diyan07-ctrl/esp32-gesture-controlled-drone/hardware/schematics/README.md

# Electrical drawing status

The provisional net drawings are [drone wiring](../../diagrams/drone-wiring.mmd), [glove wiring](../../diagrams/glove-wiring.mmd) and [power](../../diagrams/power-distribution.mmd). These are functional wiring diagrams, not a verified PCB schematic or manufacturing netlist. Actual ESC connector order, breakout supply circuit, buck model and ADC protection remain unresolved. Do not order a PCB or assemble guessed connector pinouts. Final CAD capture and ERC are blocked until exact parts are identified.
