diyan07-ctrl/esp32-gesture-controlled-drone/simulation/reports/reference/dashboard.png

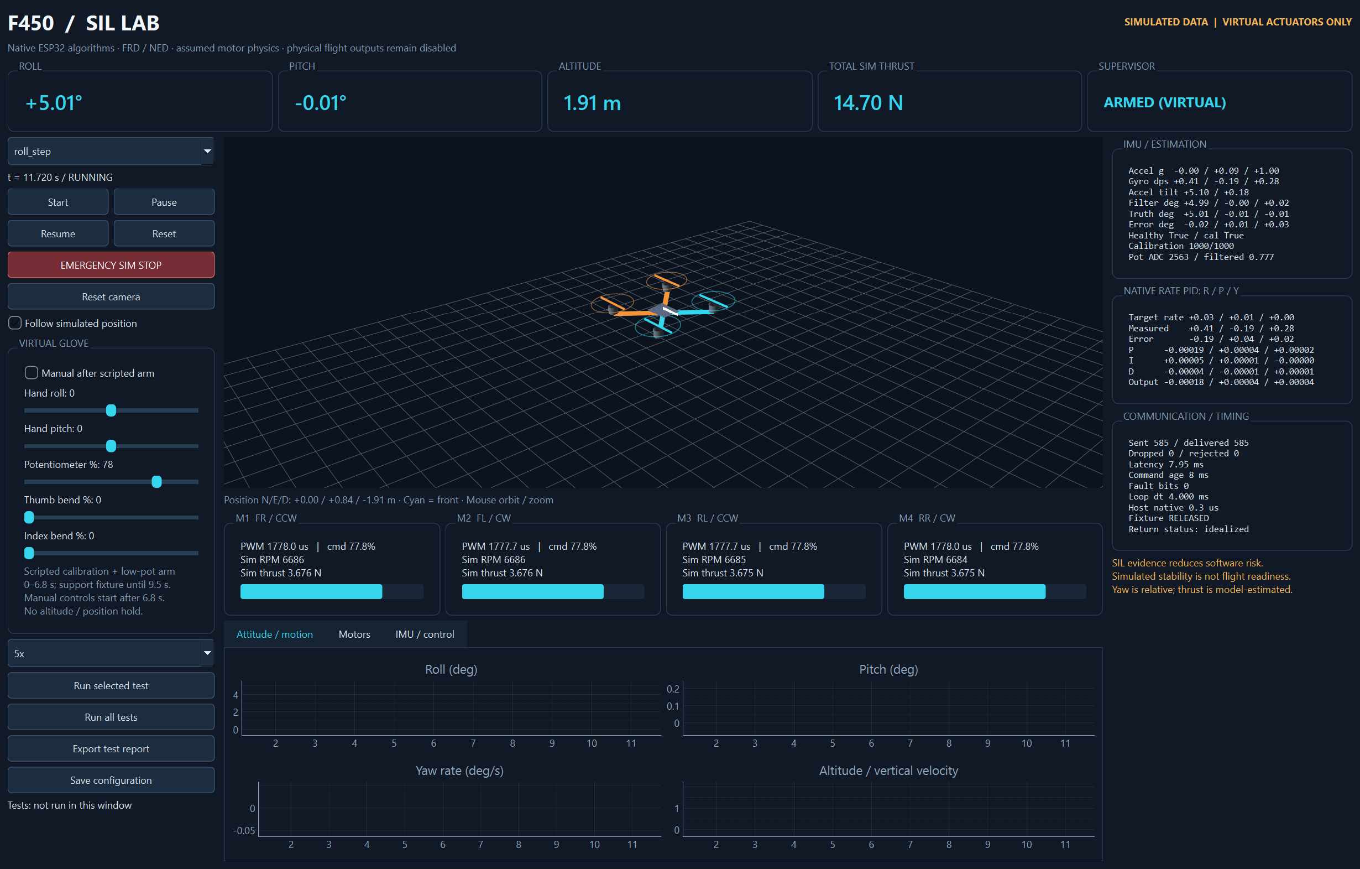
simulation/reports/reference/dashboard.png
