diyan07-ctrl/esp32-gesture-controlled-drone/simulation/reports/reference/fault-dashboard-3d.png

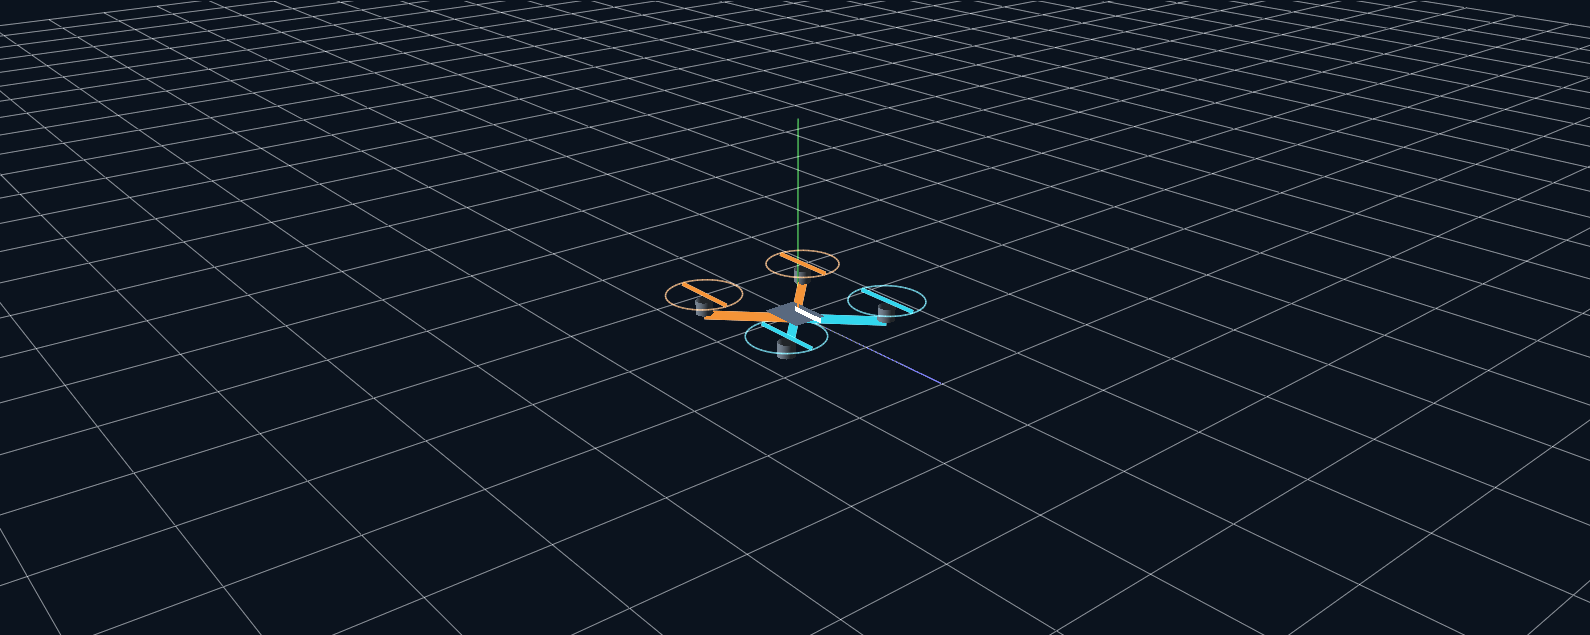
simulation/reports/reference/fault-dashboard-3d.png
