diyan07-ctrl/esp32-gesture-controlled-drone/simulation/reports/reference/plots/filter_gradual.png

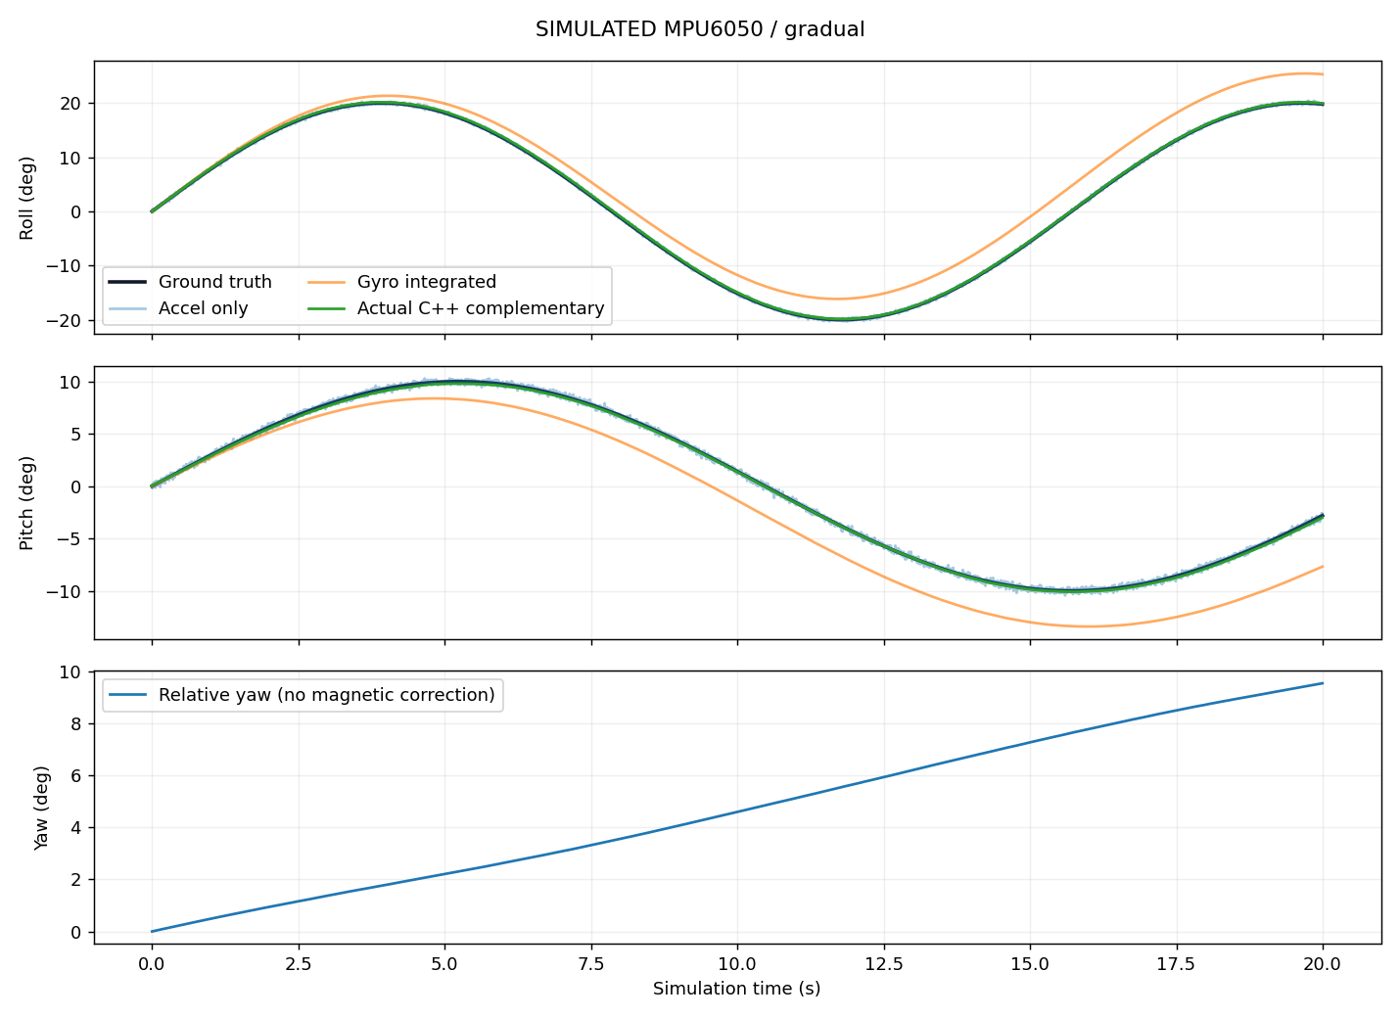
simulation/reports/reference/plots/filter_gradual.png
