diyan07-ctrl/esp32-gesture-controlled-drone/simulation/reports/reference/plots/filter_sudden.png

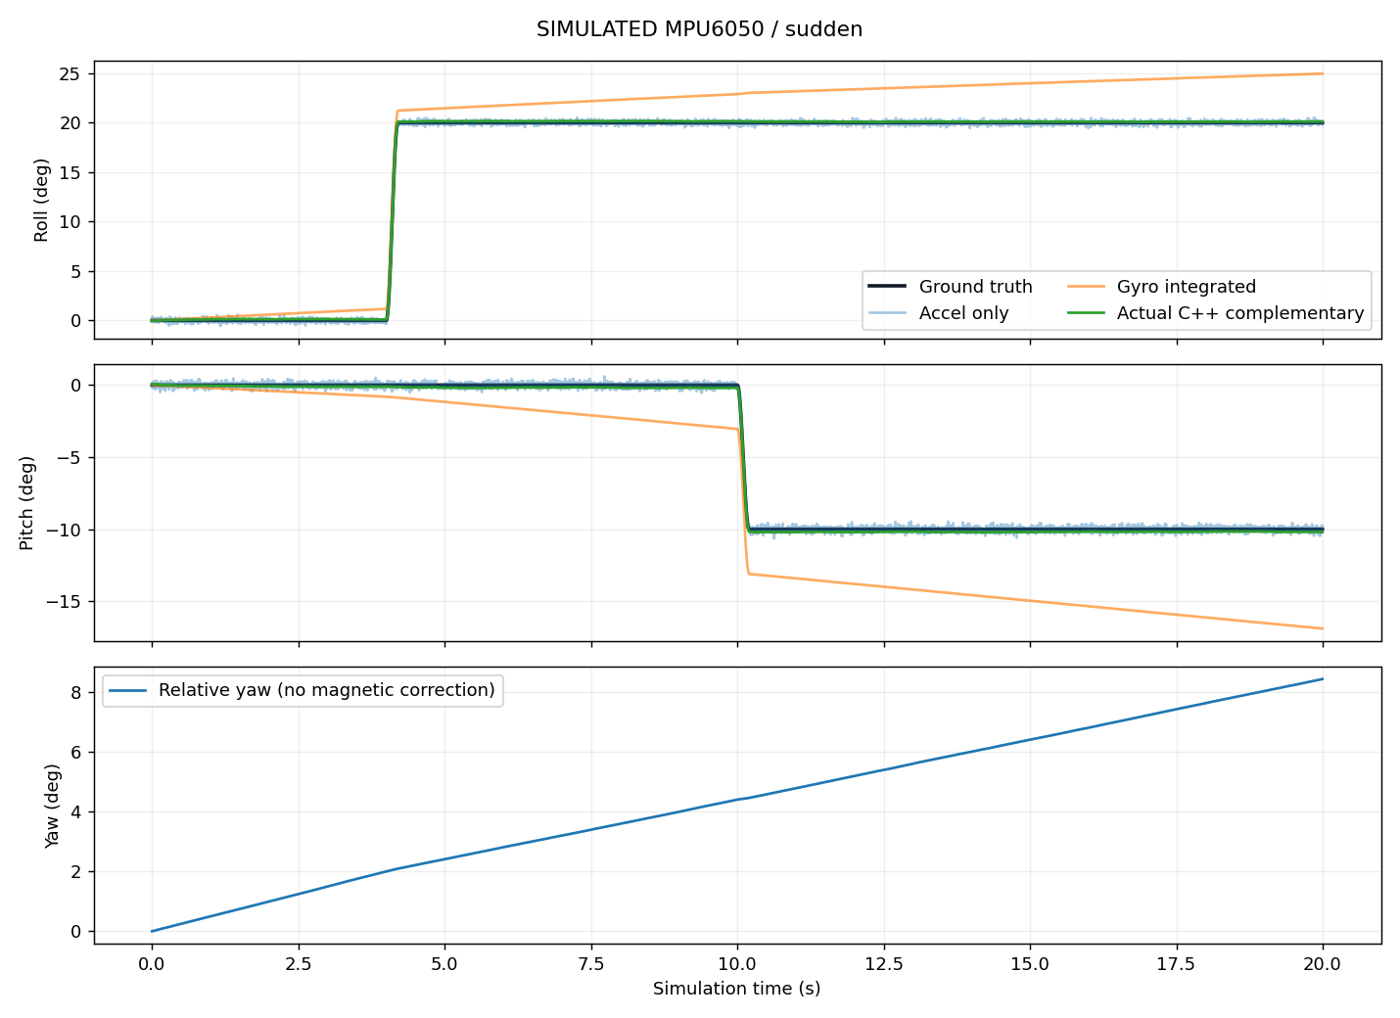
simulation/reports/reference/plots/filter_sudden.png
