diyan07-ctrl/esp32-gesture-controlled-drone/simulation/reports/reference/plots/scenario_arming.png

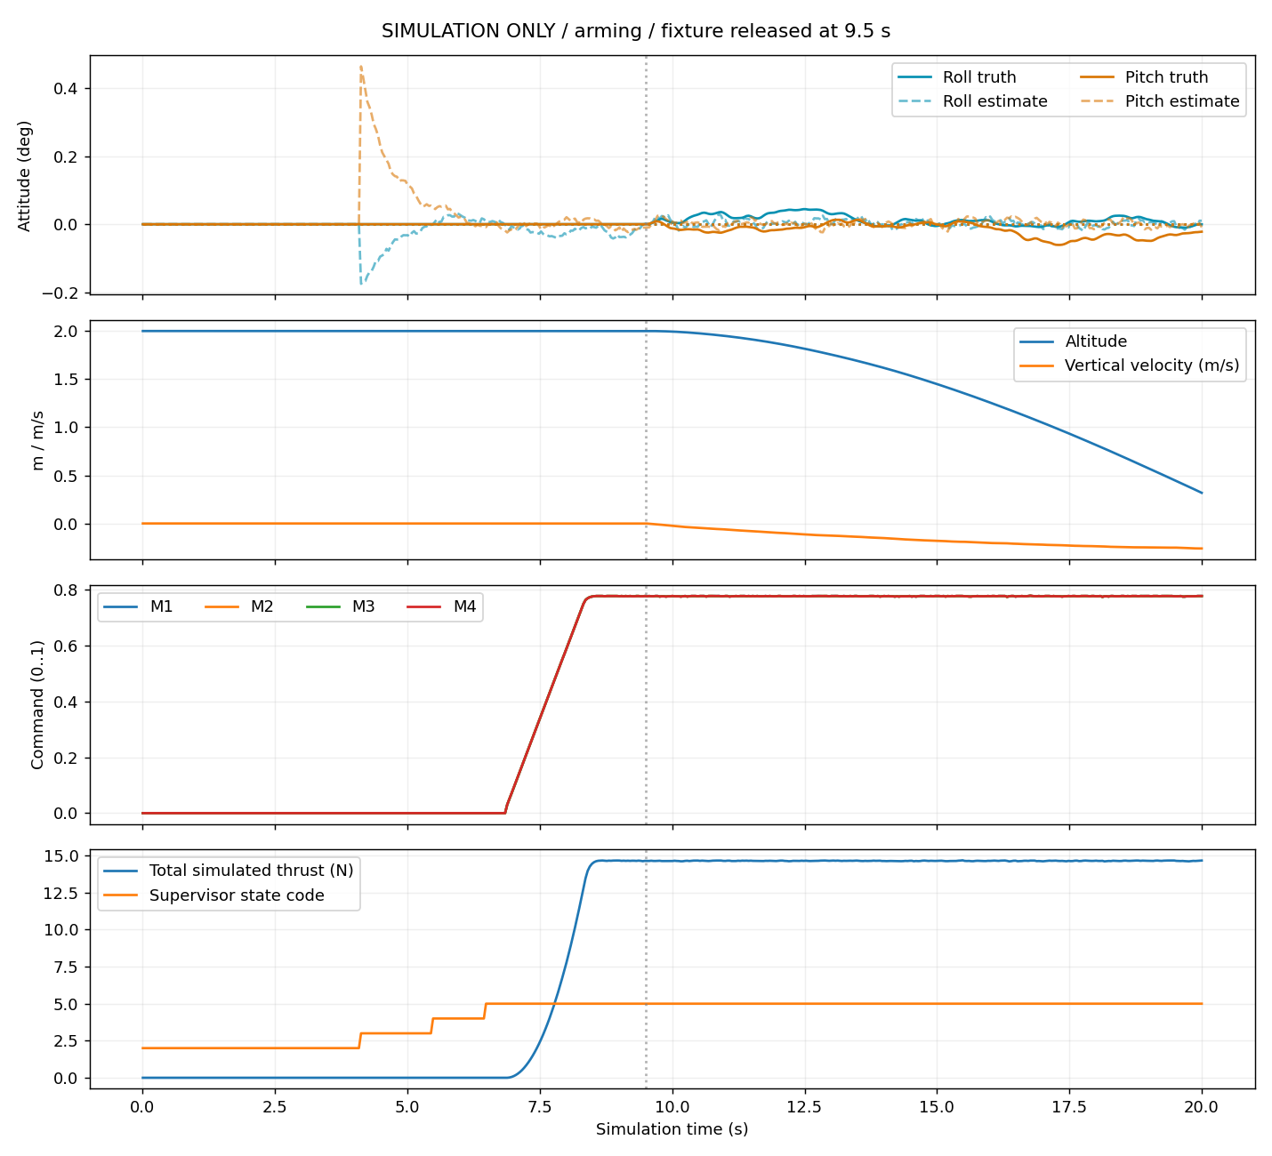
simulation/reports/reference/plots/scenario_arming.png
