diyan07-ctrl/esp32-gesture-controlled-drone/simulation/reports/reference/plots/scenario_forward_backward.png

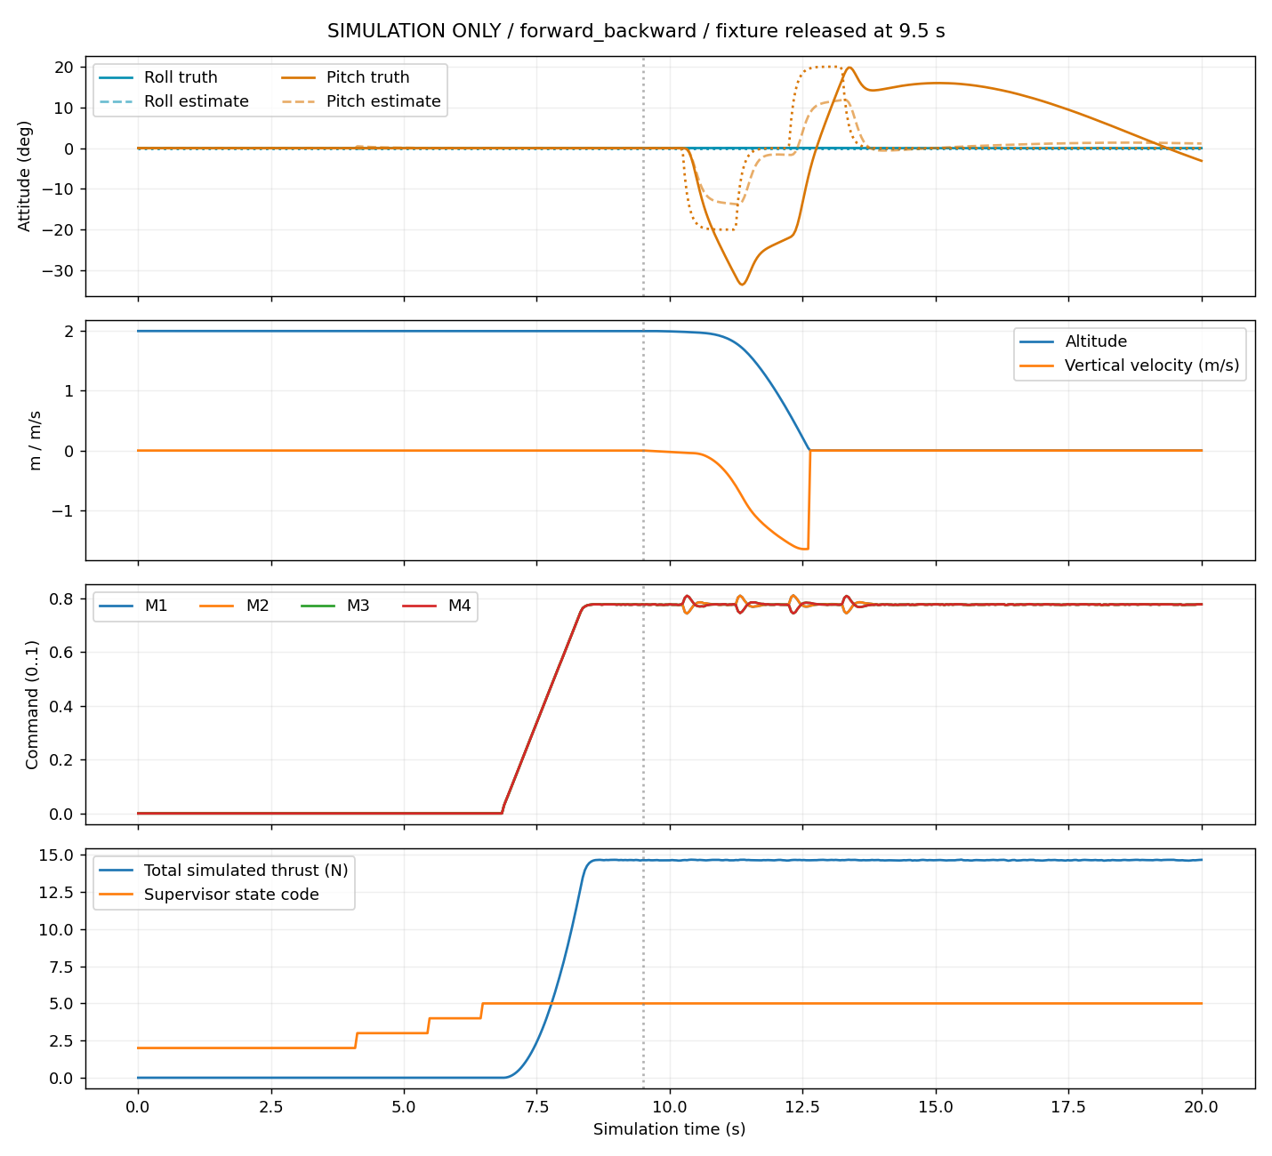
simulation/reports/reference/plots/scenario_forward_backward.png
