diyan07-ctrl/esp32-gesture-controlled-drone/simulation/reports/reference/plots/scenario_missed_deadline.png

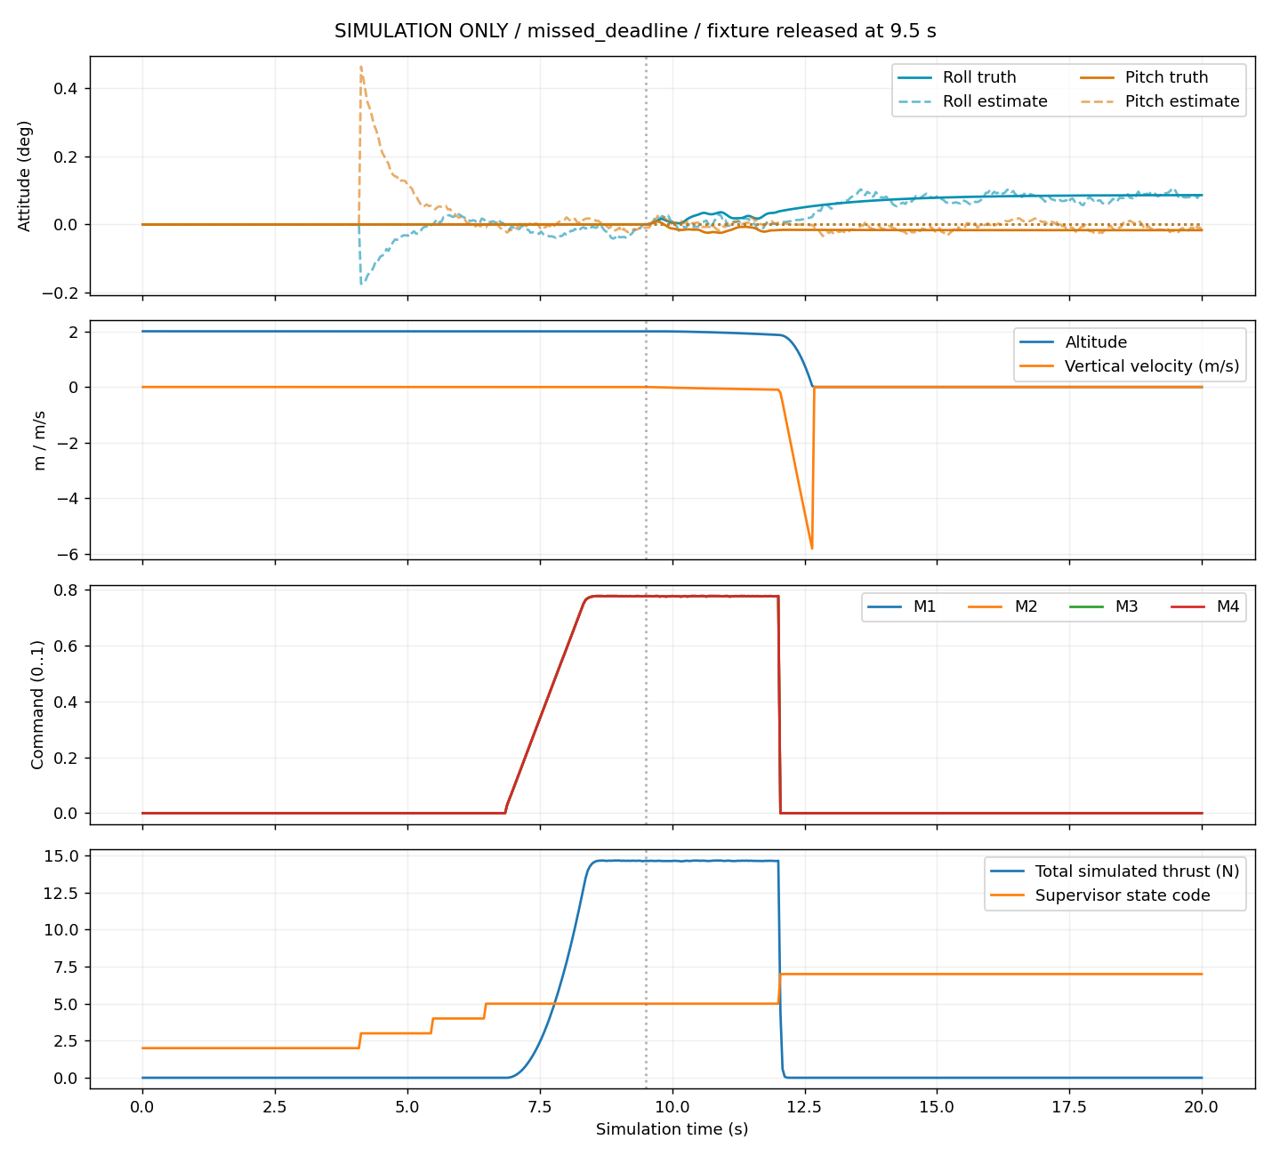
simulation/reports/reference/plots/scenario_missed_deadline.png
