diyan07-ctrl/esp32-gesture-controlled-drone/simulation/reports/reference/plots/scenario_saturation.png

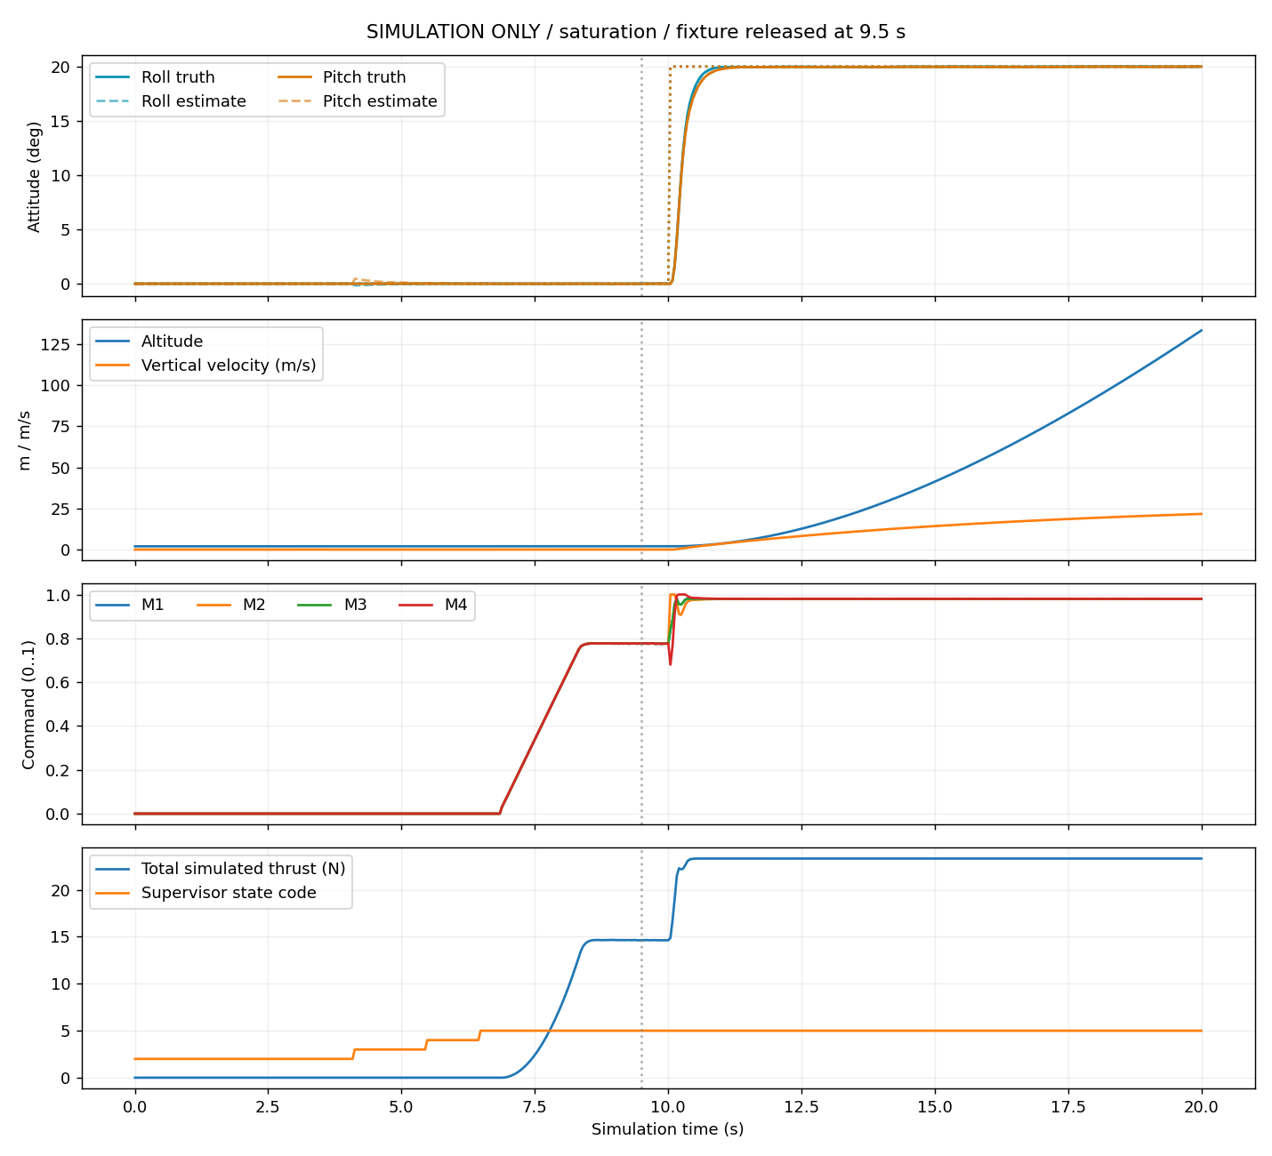
simulation/reports/reference/plots/scenario_saturation.png
