diyan07-ctrl/esp32-gesture-controlled-drone/simulation/reports/reference/plots/scenario_startup.png

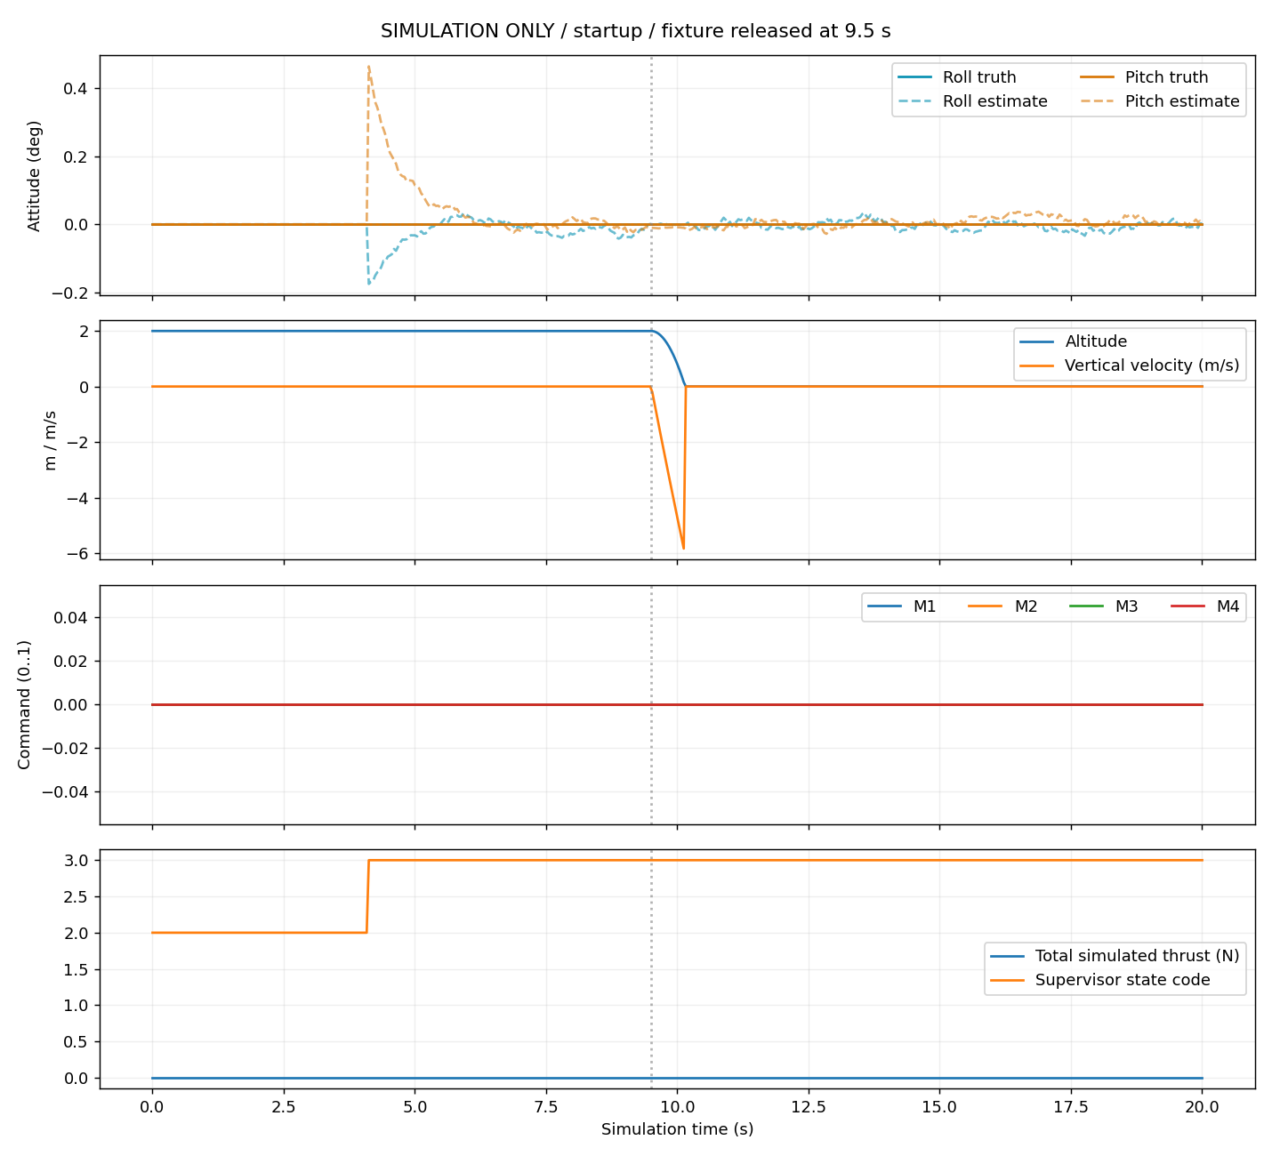
simulation/reports/reference/plots/scenario_startup.png
