diyan07-ctrl/esp32-gesture-controlled-drone/simulation/reports/reference/plots/scenario_combined_step.png

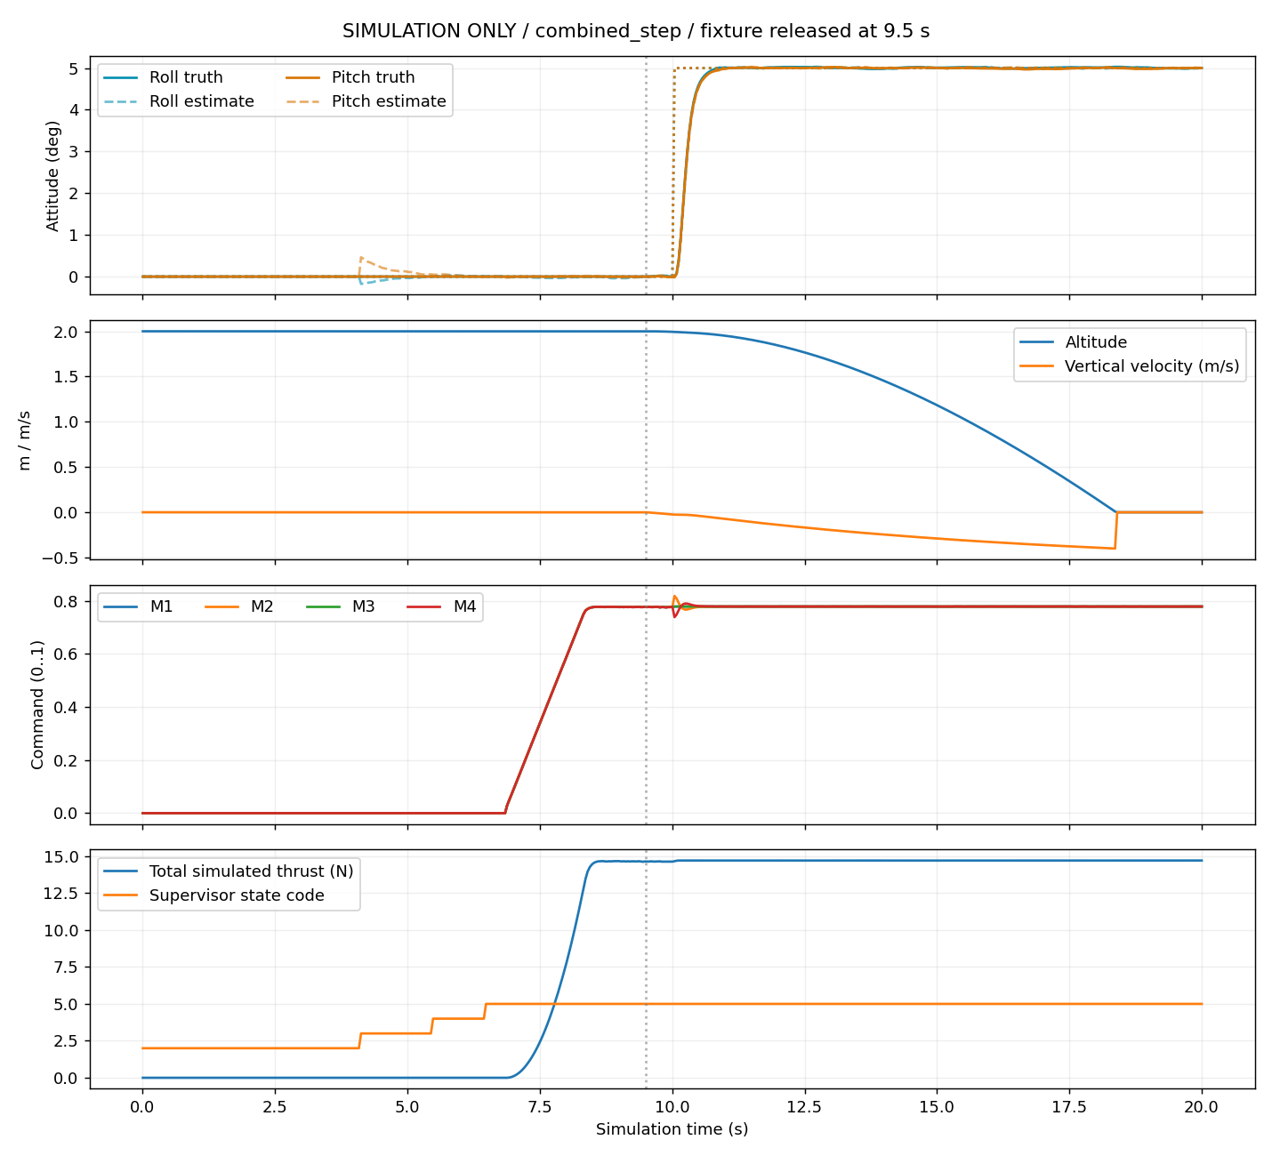
simulation/reports/reference/plots/scenario_combined_step.png
