diyan07-ctrl/esp32-gesture-controlled-drone/simulation/reports/reference/plots/scenario_pitch_step.png

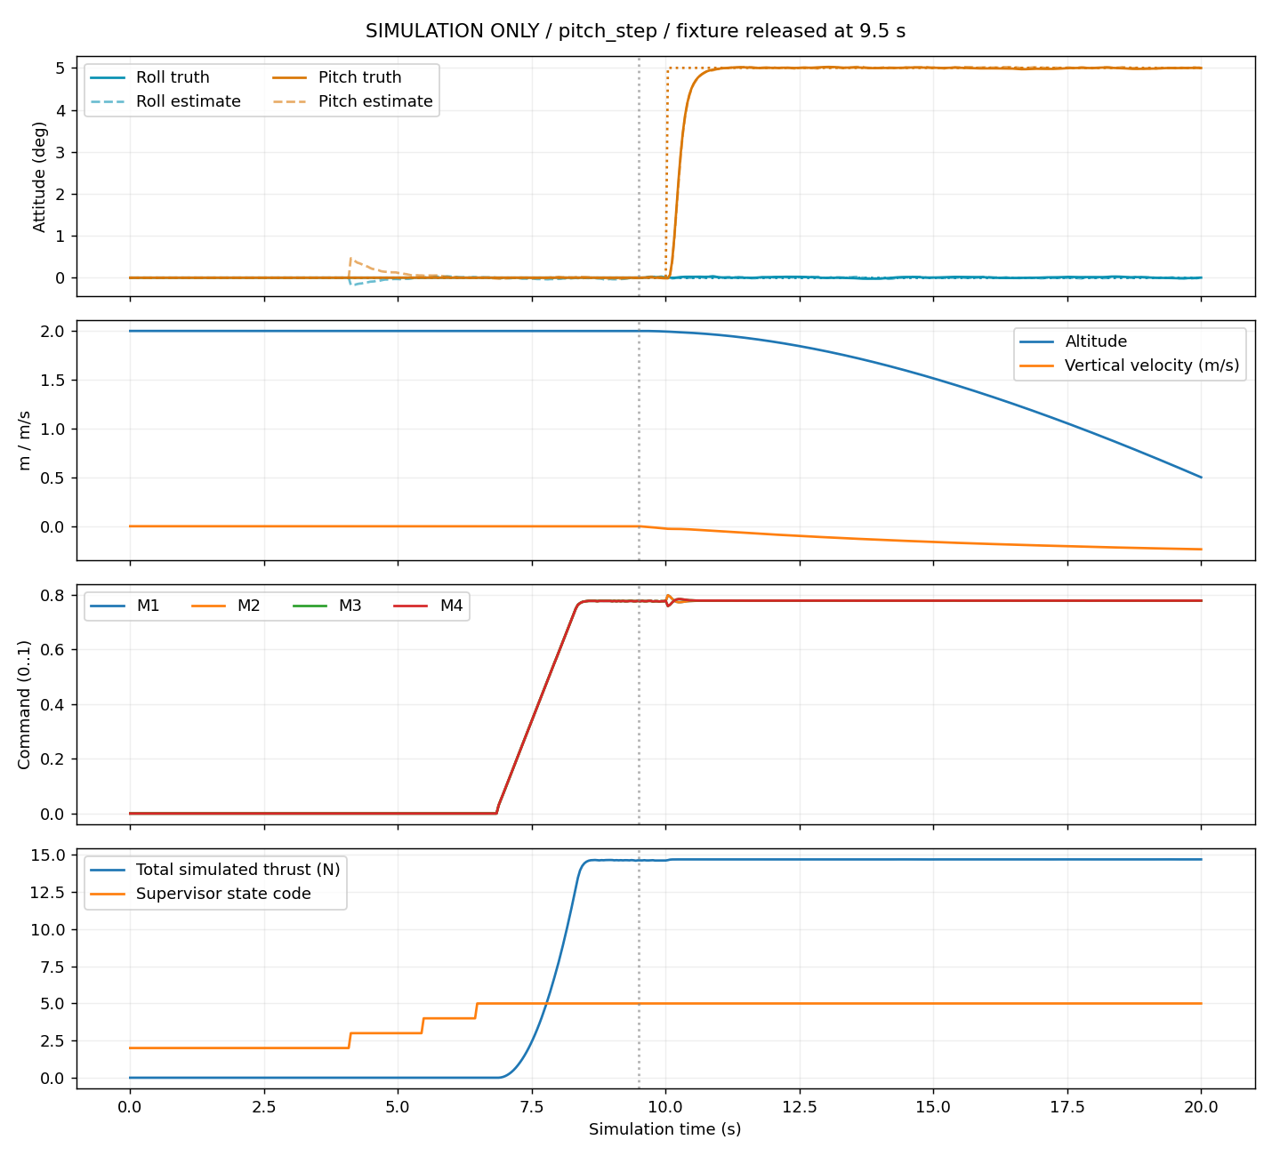
simulation/reports/reference/plots/scenario_pitch_step.png
