diyan07-ctrl/esp32-gesture-controlled-drone/(commit log)

2026-10-30 Add experimental ESP32 drone firmware and engineering documentation
    [bom.csv, motor-mapping.csv, pin-mapping.csv, supplier-availability.csv]
2026-10-30 Fix shared include discovery for ESP32 framework libraries
    [main.cpp]
2026-10-30 Record public publication and passing CI; resolve build warnings
    [imu.h]
2026-11-03 feat: complete calibrated gesture and guarded drone firmware
    [bom.csv, motor-mapping.csv, pin-mapping.csv]
2026-11-05 feat: migrate MPU6050 sensors and calibrated potentiometer throttle
    [bom.csv, pin-mapping.csv]
2026-11-05 Add motor-free BNO055 drone bench and UDP telemetry
    [bom.csv, pin-mapping.csv]
2026-11-05 Add BNO055 PID shadow bench with locked motor mode
2026-11-06 Fix F450 pulse conversion and integrate altitude and manual collective modes
    [Control.h, F450_ESP32_FlightController.ino, FlightSupport.h, Protocol.h]
